J0NAS200/smart-blinds/README.md

# Maturita
Maturitní práce z informatiky 2024/25
