J0NAS200/smart-blinds/3d_files/readme.md

**Všechny modely** (tzn. většina krytů, upevňovacích dílů a ostatního příslušenství) navrhl a vytvořil autor. 

**Výjimky** jsou pouze:  
- [Držák na krokový motor (NEMA 17 mount)](https://www.printables.com/model/20287-nema-17-mount/files)  
- [Naviják rolet (Blind gear for automated blinds)](https://www.printables.com/model/371583-blind-gear-for-automated-blinds-moeshouse/collections)  

Tyto dva modely byly staženy z portálu Printables a následně vytištěny autorem.  

**3D tisk** probíhal na tiskárně **Prusa MINI+** s **0,6mm tryskou**:  
- Všechny díly navržené autorem (kryty, převody atd.) byly tištěny z **recyklovaného PLA**.  
- Držák (mount) a naviják rolet jsou vytištěny z **PETG**, aby byly odolnější vůči vyšším teplotám a mechanickému namáhání.

**Montáž víka baterie** je řešena pomocí **2mm ISO šroubů**, které zajišťují pevné uzavření a snadné sundání víka v případě potřeby.
