J0NAS200/smart-blinds/(list of files, cad)

Other CAD files:
3d_files/battery_lid.f3d
3d_files/blinds_box.f3d
3d_files/box_lid.f3d
